ThomasVuNguyen/openflexure-v7/openscad/accessories/README.md

# Microscope accessories

This folder contains OpenSCAD files that build assemby tools and
various accessories for the microscope that aren't considered part of
the main build.  Currently this includes an adapter for a 1" disc
(allowing you to mount e.g. an optical fibre holder or resolution
target on the sample stage) and some options for mounting the
microscope onto a plate.

There are also foot prints of the microscope that are rendered into
SVGs to be use to (laser) cut case inserts or stands or the like.

These files aren't generally included in the build script, 
and tend not to be extensively tested - so treat them
with caution and do check they actually work before relying
on them.
