ThomasVuNguyen/openflexure-v7/docs/mount_optics_and_microscope.md

# Mount the optics and the microscope

{{include: mount_any_internals_and_microscope.md}}
