ThomasVuNguyen/openflexure-v7/docs/parts/electronics/camera_cable_200mm.md

----------------------
PartData:
  Name: Raspberry Pi Camera Ribbon Cable (200mm)
  Specs:
    Cable type: Type B FFC/FPC cable
    Length: 20cm
    Pitch: 1mm
    Pins: 15
  Suppliers:
    Farnell (Part number also for Newark and Onecall):
      Link: https://uk.farnell.com/multicomp-pro/mp-ffca10152003b/ffc-cord-15p-opposite-side-200mm/dp/3385343
      PartNo: 3385343
    The Pi Hut:
      Link: https://thepihut.com/products/flex-cable-for-raspberry-pi-camera-or-display-200mm-8
      PartNo: 102929
-----------------------
# 200mm ribbon cable for Raspberry Pi Camera Module V2.1. 

This is a 15 pin flat ribbon cable referred to as a FPC or FFC Type B cable with 1mm pitch.  
The 200mm length is longer than the standard ribbon cable the Pi Camera is sold with.

{{include: parts/electronics/camera_cable_warning.md}}
