ThomasVuNguyen/openflexure-v7/docs/parts/electronics/camera_cable_300mm.md

----------------------
PartData:
  Name: Raspberry Pi Camera Ribbon Cable (300mm)
  Specs:
    Cable type: Type B FFC/FPC cable
    Length: 30cm
    Pitch: 1mm
    Pins: 15
  Suppliers:
    Farnell (Part number also for Newark and Onecall):
      Link: https://uk.farnell.com/multicomp-pro/mp-ffca10153052b/ffc-cable-1-0mm-15way-305mm-white/dp/3527258
      PartNo: 3527258
    The Pi Hut:
      Link: https://thepihut.com/products/flex-cable-for-raspberry-pi-camera-or-display-300mm-12
      PartNo: 102795
-----------------------
# 300mm ribbon cable for Raspberry Pi Camera Module V2.1. 

This is a 15 pin flat ribbon cable referred to as a FPC or FFC Type B cable with 1mm pitch.  
The 300mm length is longer than the standard ribbon cable the Pi Camera is sold with.

{{include: parts/electronics/camera_cable_warning.md}}
