ThomasVuNguyen/openflexure-v7/docs/high_res_microscope.md

# High-resolution microscope

This is the standard research version of the OpenFlexure Microscope. It supports Standard RMS threaded objectives. It is a fully functioning motorised laboratory grade microscope. 

{{include: version_header_text.md}}

1. [.](test_your_printer.md){step}
1. [.](printing.md){step, var_type: high_res, var_mass_pla: 375}
1. [.](prepare_main_body.md){step}
1. [.](prepare_stand.md){step}
1. [.](actuator_assembly.md){step, var_n_actuators:3}
1. [.](high_res_optics_module.md){step}
1. [.](mount_optics_and_microscope.md){step, var_optics: rms}
1. [.](illumination.md){step, var_type: high_res}
1. [.](mount_illumination.md){step, var_type: high_res}
1. [.](motors.md){step, var_optics: rms}
1. [.](attach_clips.md){step, var_optics: rms}
1. [.](prepare_pi_and_sangaboard.md){step}
1. [.](wiring.md){step, var_optics: rms}
1. [.](finished.md){step, var_optics: rms}

A render of the completed high resolution microscope

There is also an [interactive 3D view](interactive_3d_view_rms.md) of the finished microscope.
