ThomasVuNguyen/openflexure-v7/docs/interactive_3d_view_upright.md

# Interactive 3D view of the OpenFlexure Microscope

Below is an interactive 3D view of the assembled microscope. This page shows an upright microscope with low cost optics using a Raspberry Pi camera module, and employing that camera module's lens as the microscope objective.

A render of the completed microscope
