ThomasVuNguyen/openflexure-v7/docs/motors.md

# Assemble the motors

{{BOM}}

[M3x10 cap head screws]: parts/mechanical.yml#CapScrew_M3x10mm_SS
[28BYJ-48 micro geared stepper motors]: parts/electronics.yml#28BYJ-48
[2.5mm Ball-end Allen key]: parts/tools/2.5mmBallEndAllenKey.md
[No 2 6.5mm self tapping screws]: parts/mechanical.yml#SelfTap_PoziPan_No2x6.5_SS
[#1 pozidrive screwdriver]: parts/tools/pozidrive_1_screwdriver.md "{cat:tool}"

## Attach the small gears {pagestep}





* Take a [stepper motor][28BYJ-48 micro geared stepper motors]{qty:3, cat:electronic} and a [small gear][small gears](fromstep){qty:3, cat:printedpart}.
* Place the motor on the work surface with the shaft pointing up.
* Align the flat sides of the motor shaft with the flat sides of the hole in the gear.
* Push the gear onto the motor with the flanged side downwards (motor side).
* Take two [self tapping screws][No 2 6.5mm self tapping screws]{qty: 6, cat:mech} and drive them fully into the holes on either side of the shaft, using a [#1 pozidrive screwdriver]{qty:1, cat:tool}
* Check that the gear is fully pushed on to the motor and the screws are fully in, so that the screw heads almost sit on the end of the motor shaft and the top of the heads are barely protruding from the gear. 
* Repeat for the other two motors

>i It is important to keep track of which motor cable corresponds to which axis. You may find it helpful to mark each cable connector with a marker or different-coloured tape before continuing.

## Check that the actuators are centred {pagestep}

Check actuator position
Check actuator position

* Look through the nut hole in the x actuator, above the 'X' logo
{{include: centre_actuators_text.md}}

## Attach the x and y motors {pagestep}




Note that each motor has a cable tidy cap that is different. Which cap to use should be apparent from the shape.

* Get a [2.5mm Ball-end Allen key]{qty:1, cat:tool} ready
* Feed the cable from the motor through the rectangular channel in the outer wall by the x actuator.
* Place the motor on the motor lugs with the small gear towards the outside of the microscope
* Check that the small gear and the large gear are meshed correctly
* Check that the motor screw points sit in the channel in the top of the motor lugs
* Take the x [cable tidy cap][cable tidy caps](fromstep){qty:3, cat:printedpart, note: "Each cap is a different shape"} and place it over the motor
* Check that the motor cable is running through the cable tidy rather than pinched underneath.
* Fasten the motor and cable tidy caps to the motor lugs with two [M3x10 cap head screws]{qty:6, cat:mech}
* Repeat for y-actuator

## Attach the z motor {pagestep}




{{includetext: " 
>i There is no motor attached to the z-actuator on the main body
", if: var_optics is upright}}  

* Feed the cable of the z motor down the rectangular slot to the left of the z actuator {{includetext: "on the main body", if: var_optics is upright}}
* Attach the motor to the z-actuator {{includetext: "of the separate z-actuator ", if: var_optics is upright}} in the same way as the x and y actuators
 {{includetext: "* Attach the z cable tidy cap to the motor lugs on the main body with two [M3x10 cap head screws]{qty:2, cat:mech}", if: var_optics is upright}}

## Secure the cable tidy caps {pagestep}




* Secure the x cable tidy cap with a [self tapping screw][No 2 6.5mm self tapping screws]{qty: 2, cat:mech} using a  [#1 pozidrive screwdriver]{qty:1, cat:tool}
* Repeat for the y cable tidy cap
