ThomasVuNguyen/openflexure-v7/docs/mount_any_internals_and_microscope.md

{{BOM}}

[2.5mm Ball-end Allen key]: parts/tools/2.5mmBallEndAllenKey.md

## Mount the {{includetext:"optics", if: var_optics is not upright}}{{includetext:"illumination module", if: var_optics is upright}} {pagestep}






* Get the [2.5mm Ball-end Allen key]{qty:1, cat:tool} ready{{includetext:"
* Hold the [complete optics module](fromstep){qty:1, cat:subassembly}  with the cable arranged to one side of the camera platform", if: var_optics is c270}}
* {{includetext:"Take the [complete optics module](fromstep){qty:1, cat:subassembly} and pass", if: var_optics is not upright and var_optics is not c270}}{{includetext:"Take the [assembled illumination module](fromstep){qty:1, cat:subassembly} and pass", if: var_optics is upright}} {{includetext:"Pass", if: var_optics is c270}} it {{includetext:"through the bottom", if: var_optics is not c270}}{{includetext:"between the front legs", if: var_optics is c270}} of the [microscope][microscope with assembled actuators](fromstep){qty:1, cat:subassembly}.
* Insert exposed the mounting screw on the optics module through the keyhole on the z-actuator.






* Insert the Allen key through the teardrop shaped hole on the front of the microscope. Until it engages with the mounting screw.
* Slide the {{includetext:"optics module", if: var_optics is not upright}}{{includetext:"illumination module", if: var_optics is upright}} up the keyhole as high as it will go.
* Tighten the screw with the Allen key to lock the optics in place.

{{include: mount_microscope.md}}
