ThomasVuNguyen/openflexure-v7/docs/mount_illumination.md

# Mount the illumination

{{BOM}}

[M3 nut]: parts/mechanical.yml#Nut_M3_SS "{cat:mech}"
[M3 stainless steel washers]: parts/mechanical.yml#Washer_M3_SS "{cat:mech}"
[M3x10 cap head screws]: parts/mechanical.yml#CapScrew_M3x10mm_SS "{cat:mech}"
[2.5mm Ball-end Allen key]: parts/tools/2.5mmBallEndAllenKey.md "{cat:tool}"

## Mount the dovetail {pagestep}




* Place the [illumination dovetail][Illumination dovetail](fromstep){qty:1, cat:printedpart} onto the stage above the z-actuator of the main body.
* Secure in place with two [M3x10 cap head screws]{qty:2} and 2 [M3 Washers][M3 stainless steel washers]{qty: 2} (using [2.5mm Ball-end Allen key]{qty:1})

## Insert the illumination wiring {pagestep}





* Take the [assembled illumination module](fromstep){qty: 1, cat:subassembly}
* Pass the illumination cable from the top to the bottom of the cable guide in the illumination dovetail.
* Pass the illumination cable from the top to the bottom of the cable guide in the main body, between the Z gear and the Y gear.

## Mount the condenser arm {pagestep}





* Slide the condenser arm into the illumination dovetail until the bottom of the illumination module is about 5mm from the top of the microscope stage
* Tighten the thumbscrew by hand to lock the arm in place
* You will need to fine tune the position to focus the illumination on the sample when you first use the microscope
