ThomasVuNguyen/openflexure-v7/docs/prepare_main_body_motor_nuts.md

[M3 nut]: parts/mechanical.yml#Nut_M3_SS

## Embed mounting nuts for the X and Y motors {pagestep}





* Repeat the steps used above to add two [M3 nuts][M3 nut]{qty:4, cat:mech} each to the X and Y motor mounts (Only Y axis side shown in the images)

{{include:prepare_main_body_z_nuts.md}}
