ThomasVuNguyen/openflexure-v7/docs/prepare_main_body_z_nuts.md

[M3 nut]: parts/mechanical.yml#Nut_M3_SS

## Embed mounting nuts for the Z motor {pagestep}





* Repeat the steps used above to add two [M3 nuts][M3 nut]{qty:2, cat:mech} to the Z motor mount
