ThomasVuNguyen/openflexure-v7/docs/usb_cameras/c270_preparation.md

# Prepare the Logitech C270 HD webcam for mounting 

This section describes how to disassemble a Logitech C270 HD webcam and prepare it to use with C270 versions of Openflexure optics modules. The Logitech C270 HD webcam is not supported in the Openflexure software, but it can be used with many simple webcam programs.

{{BOM}}

[flat blade screwdriver]: ../parts/tools/flat_blade_screwdriver.md "{cat:tool}"
[#0 Phillips screwdriver]: ../parts/tools/phillips_0_screwdriver.md "{cat:tool}"
[side cutters]: ../parts/tools/precision-wire-cutters.md "{cat:tool}"
[pliers]: ../parts/tools/pliers.md "{cat:tool}"

[Logitech C270 HD webcam]: ../parts/electronics.yml#Logitech_C270 "{cat:electronic}"

>! **Warning**
>! 
>! You will need to break the case of the camera, and you will need to take care not to damage the camera board and sensor.   
>! Do this at your own risk

{{include: manual_optics_note.md, if: var_body is _manual}}

## Open the C270 case {pagestep}






* Take the [Logitech C270 webcam][Logitech C270 HD webcam]{qty: 1} and place it on a clean surface
* Release the outer bezel with a [flat blade screwdriver]{qty:1}
* Remove the bezel and discard it
* Unscrew three screws holding the inner front cover, using a [#0 Phillips screwdriver]{qty:1}
* Save the screws 
* Remove the inner cover and discard it

## Remove the camera board from the case {pagestep}






>! **Caution!**
>!
>! The camera board is static sensitive.

* Before touching the camera board touch a metal earthed object. If you own one, consider wearing and anti-static strap
* Remove the small rubber tube from the microphone and discard it. The microphone is the cylindrical component in the middle of the board, it is the largest component other than the camera.
* Unscrew two screws holding the camera board, using a [#0 Phillips screwdriver]{qty:1}
* Save the screws. You will need four of the five that you have saved for mounting the camera if you are using a lens spacer. You will need one if you are using a high resolution optics module. Keep the rest as spares
* Release the board from the case. It is still attached to the case by the cable
* Remove the E-clip from the cable retainer with a [flat blade screwdriver]{qty:1}
* Release the cable retainer from the case
* Cut the case to make a slot from the cable hole to the edge, using [side cutters]{qty: 1}. Take care not to cut the cable
* Remove the board cable from the case and discard the case.

## Remove the microphone {pagestep}





* Grasp the microphone with small [pliers]{qty: 1}
* Carefully twist forwards and backwards to break the small wires connecting the microphone to the board (you could alternatively unsolder the wires from the back of the board). Discard the microphone
* Remove the white plastic spacer and discard it
* If the microphone wires remain attached to the PCB,  grasp them with small [pliers]{qty: 1}. Twist them to break and discard them

## Remove the lens {pagestep}




>! **Caution!**
>!
>! The camera sensor is very delicate  
>! Work in a dust-free area

* Place the camera board with the lens facing down
* Unscrew two screws holding the lens mount to the camera board, using a [#0 Phillips screwdriver]{qty:1} 
* Save both screws for mounting the camera if you are using an Openflexure RMS optics module. These screws are different from the others as they have a small flange
* Turn the camera board over 
* Hold the lens assembly and carefully pull it from the board. The lens assembly is held with double-sided tape and requires a little force to remove.
* Retain the lens assembly if you are going to use the basic optics module with a lens spacer
* Remove the small foam pad from the board, next to the lens mount

>! **Caution!**
>!
>! Attach the camera sensor to your optics module as soon as possible so that it does not collect dust 

## Prepare the lens to use in the basic optics module  {pagestep}



* Grasp the square lens mount and the knurled round lens holder
* Unscrew the lens from the mount. There is some force required to start to unscrew the lens as it is held in place with a little glue
* Sometimes the glue is too stiff to unscrew using fingers. Carefully use a pair of small [pliers]{qty: 1} to hold the knurled round lens holder

The [prepared Logitech C270 camera]{output, qty:1} and lens are now ready to attach to your {{includetext:"optics module or", if: , if: var_body is not _manual}} lens spacer

[No 1 self tapping screws]{output, qty:5, hidden}
[No 1 self tapping flanged screws]{output, qty:2, hidden}
[C270 camera board]{output, qty:1, hidden}
