ThomasVuNguyen/openflexure-v7/docs/low_cost_microscope.md

# Low-cost microscope

This is a lower cost version of the OpenFlexure Microscope. It uses the lens from the Raspberry Pi Camera to produce a microscope with field of view about 750×560μm, similar to using a 20x objective. It is motorised, but you can also build it as a manual microscope.

{{include: version_header_text.md}}

1. [.](test_your_printer.md){step}
1. [.](printing.md){step, var_type: low_cost, var_mass_pla: 375}
1. [.](prepare_main_body.md){step}
1. [.](prepare_stand.md){step}
1. [.](actuator_assembly.md){step, var_n_actuators:3}
1. [.](basic_optics_module.md){step, var_lens: pi_lens}
1. [.](mount_optics_and_microscope.md){step, var_optics: low_cost}
1. [.](illumination.md){step, var_type: low_cost}
1. [.](mount_illumination.md){step, var_optics: low_cost}
1. [.](motors.md){step, var_optics: low_cost}
1. [.](attach_clips.md){step, var_optics: low_cost}
1. [.](prepare_pi_and_sangaboard.md){step}
1. [.](wiring.md){step, var_optics: low_cost}
1. [.](finished.md){step, var_optics: low_cost}

A render of the completed microscope using the Raspberry Pi camera module's lens.

There is also an [interactive 3D view](interactive_3d_view_low_cost.md) of the finished microscope.
