ThomasVuNguyen/openflexure-v7/docs/parts/materials/black_pla_filament.md

# Black PLA filament

Certain parts specifically require black filament ([more information](../../info_pages/why_optics_black.md)).

Use the same [type of filament](pla_filament.md) as for other parts.
