ThomasVuNguyen/openflexure-v7/rendering/librender/logos/MicroSD-Logo.dxf

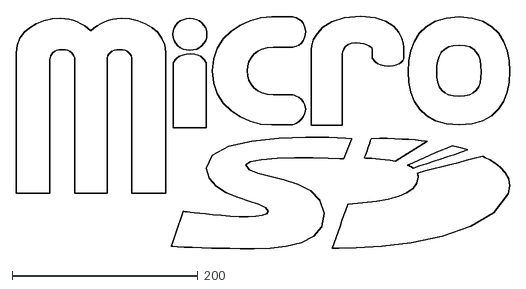
[picture p1: CAD file, 2026-09-27]
rendering/librender/logos/MicroSD-Logo.dxf
531.0 x 250.0
