ThomasVuNguyen/openflexure-v7/openscad/lens_spacer.scad

/**
* This is an alternative optics module that is to
* be used together with the camera platform, to make a cheap
* optics module that uses the webcam lens.  New in this version
* is compatibility with the taller stage (because the sensor is
* no longer required to sit below the microscope body).
*/


use <./libs/microscope_parameters.scad>
use <./libs/lib_optics.scad>
use <./libs/optics_configurations.scad>

lens_spacer_stl();

module lens_spacer_stl(){
    params = default_params();
    optics_config = pilens_config();
    lens_spacer(params, optics_config);
}
