ThomasVuNguyen/openflexure-v7/openscad/accessories/picamera_2_lens_removal_tool.scad

// this file just pulls out one module from picamera_2

use <../libs/cameras/picamera_2.scad>

picamera_2_lens_removal_tool();
