ThomasVuNguyen/openflexure-v7/(list of files, cad)

Other CAD files:
rendering/electronics/led_board_colors/led_board_CAD1EE.stl
rendering/electronics/sangaboard_colors/sangaboard_151618.stl
rendering/electronics/led_board_colors/led_board_DBBC7E.stl
rendering/electronics/sangaboard_colors/sangaboard_200235D4.stl
rendering/electronics/led_board_colors/led_board_FFFFFF.stl
rendering/electronics/sangaboard_colors/sangaboard_B66D2E.stl
rendering/electronics/led_board_colors/led_board_262525.stl
rendering/electronics/sangaboard_colors/sangaboard_E4E3CF.stl
rendering/electronics/led_board_colors/led_board_F5F5F5.stl
rendering/electronics/sangaboard_colors/sangaboard_5F5F5F.stl
rendering/electronics/led_board_colors/led_board_808080.stl
rendering/electronics/sangaboard_colors/sangaboard_F5F5F5.stl
rendering/electronics/led_board_colors/led_board_BF9C3B.stl
rendering/electronics/sangaboard_colors/sangaboard_614537.stl
rendering/electronics/led_board_colors/led_board_200235D4.stl
rendering/electronics/sangaboard_colors/sangaboard_292929.stl
rendering/electronics/led_board_colors/led_board_000000.stl
rendering/electronics/sangaboard_colors/sangaboard_D2D1C7.stl
rendering/electronics/sangaboard_colors/sangaboard_262525.stl
rendering/electronics/sangaboard_colors/sangaboard_808080.stl
rendering/electronics/sangaboard_colors/sangaboard_DBBC7E.stl
rendering/electronics/sangaboard_colors/sangaboard_464646.stl
rendering/electronics/sangaboard_colors/sangaboard_BF9C3B.stl
rendering/electronics/sangaboard_colors/sangaboard_B0A998.stl
rendering/electronics/sangaboard_colors/sangaboard_000000.stl
openscad/lens_spacer_b0196.scad
openscad/lens_spacer_c270.scad
openscad/main_body_manual.scad
rendering/librender/rendered_main_body_manual.scad
openscad/accessories/1_inch_disc_holder.scad
openscad/accessories/actuator_drilling_jig.scad
openscad/accessories/actuator_tension_band.scad
openscad/accessories/picamera_2_gripper.scad
openscad/accessories/slide_box.scad
openscad/accessories/upright_z_actuator_mount_10mm_sample.scad
openscad/accessories/upright_z_actuator_mount_5mm_sample.scad
openscad/actuator_assembly_tools.scad
openscad/c270_backshell.scad
openscad/camera_platform.scad
openscad/camera_platform_b0196.scad
openscad/camera_platform_c270.scad
openscad/condenser.scad
openscad/condenser_aperture.scad
openscad/condenser_board_spacer.scad
openscad/condenser_diffuser.scad
openscad/condenser_led_holder.scad
openscad/condenser_lid.scad
openscad/electronics_drawer.scad
openscad/feet.scad
openscad/fl_cube.scad
openscad/foot_cap.scad
openscad/gear_tools.scad
openscad/gear_tools_ratios.scad
openscad/illumination_dovetail.scad
openscad/illumination_thumbscrew.scad
openscad/large_gears.scad
openscad/led_array_holder.scad
openscad/lens_tool.scad
openscad/microscope_stand.scad
openscad/microscope_stand_no_pi.scad
openscad/nano_converter_plate.scad
openscad/nano_converter_plate_gripper.scad
openscad/picamera_2_cover.scad
openscad/reflection_illuminator.scad
openscad/rms_optics_module.scad
openscad/sample_clips.scad
openscad/separate_z_actuator.scad
openscad/separate_z_actuator_manual.scad
openscad/simple_post_stand.scad
openscad/slide_riser.scad
openscad/small_gears.scad
openscad/test_pieces/leg_test.scad
openscad/test_pieces/nut_trap_test.scad
openscad/test_pieces/rms_thread.scad
openscad/test_pieces/trylinder_selftap_holes_test.scad
openscad/thumbwheels.scad
openscad/upright_condenser.scad
openscad/upright_condenser_platform.scad
openscad/upright_feet.scad
openscad/upright_large_gears.scad
openscad/upright_z_actuator_mount.scad
rendering/band_tool_assembly.scad
rendering/brim_and_ties_separate_z_actuator.scad
rendering/complete_microscope.scad
rendering/complete_microscope_low_cost.scad
rendering/complete_microscope_manual.scad
rendering/complete_microscope_rms.scad
rendering/complete_microscope_upright.scad
rendering/condenser_assembly.scad
rendering/librender/optics.scad
rendering/librender/render_settings.scad
rendering/librender/rendered_components.scad
rendering/librender/rendered_separate_z_actuator.scad
rendering/librender/rendered_separate_z_actuator_manual.scad
rendering/librender/tools.scad
rendering/microscope_stand.scad
rendering/mount_electronics.scad
rendering/mount_microscope.scad
rendering/mount_sample_clips.scad
rendering/mount_upright_optics.scad
rendering/optics_assembly.scad
rendering/prepare_nut_trap_test.scad
rendering/prepare_pi_and_sangaboard.scad
rendering/prepare_picamera.scad
rendering/prepare_stand.scad
rendering/rms_optics_assembly.scad
rendering/upright_condenser_assembly.scad
rendering/workaround_5mm_led.scad
