ThomasVuNguyen/openflexure-v7/docs/c270_only_printing.md

{{include: inverted_only_printing.md}}
* [Lens spacer]{output,qty:1}: [lens_spacer_c270.stl](models/lens_spacer_c270.stl){previewpage} - **This must be printed in [black][Black PLA filament]{Qty: 20g}!** [i](info_pages/why_optics_black.md)
* [Camera backshell]{output, qty:1}: [c270_camera_backshell.stl](models/c270_camera_backshell.stl){previewpage}
* [Camera platform]{output,qty:1}: [camera_platform_c270.stl](models/camera_platform_c270.stl){previewpage}

You can [download all of the STLs as a single zipfile]{{includetext: "(low-cost-stls.zip)", if: var_body is not _manual}}{{includetext: "(manual-stls.zip)", if: var_body is _manual}}{zip, pattern:"*.stl"}

[Black PLA filament]: parts/materials/black_pla_filament.md "{cat:material}"
