ThomasVuNguyen/openflexure-v7/docs/manual_microscope.md

# Manual microscope

>! This version of the OpenFlexure Microscope does not include motors. There is no autofocus or slide scanning.

This version is the simplest version of the microscope. It is suitable for manual operation using a web-cam like the Logitech C270, to produce a microscope with field of view about 750μm, similar to using a 20x objective. [Other optics modules](customisations/optics_options.md) can also be used with this microscope, using the Logitech C270 or other cameras.

{{include: version_header_text.md}}

1. [.](test_your_printer.md){step}
1. [.](printing.md){step, var_type: c270, var_body: _manual, var_mass_pla: 275}
1. [.](prepare_main_body.md){step, var_body: _manual}
1. [.](prepare_stand.md){step, var_body: _manual}
1. [.](actuator_assembly.md){step, var_body: _manual, var_actuators: _manual, var_n_actuators:3}
1. [.](usb_cameras/c270_preparation.md){step, var_body: _manual}
1. [.](basic_optics_module.md){step, var_body: _manual, var_lens: c270_lens}
1. [.](mount_optics_and_microscope.md){step, var_optics: c270, var_body: _manual}
1. [.](illumination.md){step, var_optics: c270, var_body: _manual}
1. [.](mount_illumination.md){step, var_optics: c270, var_body: _manual}
1. [.](attach_clips.md){step, var_optics: c270, var_body: _manual}
1. [.](wiring_manual.md){step, var_optics: c270, var_body: _manual}
1. [.](finished.md){step, var_optics: c270, var_body: _manual}

A render of the completed manual microscope, using a Logitech C270 camera.

There is also an [interactive 3D view](interactive_3d_view_c270_manual.md) of the finished microscope.
