ThomasVuNguyen/openflexure-v7/docs/manual_optics_note.md

>i These instructions guide you through assembling the manual microscope with most compact and low cost optics system, using a Logitech C270 webcam in a basic optics module.  
>i
>i STLs for using an Arducam B0196 webcam or a Raspberry Pi camera v2 in a similar module can be found in the list of basic optics modules on the [optics customisations](customisations/optics_options.md) page.
