ThomasVuNguyen/openflexure-v7/docs/printing_manual_only.md

* [Manual main body]{output,qty:1}: [main_body_manual.stl](models/main_body_manual.stl){previewpage} - The smart brim may require [custom print settings].
* [Microscope stand]{output, qty:1}: [microscope_stand_no_pi.stl](models/microscope_stand_no_pi.stl){previewpage} - As an even more compact but less stable option you could use the [simple_post_stand.stl](models/simple_post_stand.stl){previewpage} instead
* 3 [thumbwheels]{output,qty:3}: [thumbwheels.stl](models/thumbwheels.stl){previewpage}
