ThomasVuNguyen/openflexure-v7/docs/printing_motorised_only.md

* [Main body]{output,qty:1}: [main_body.stl](models/main_body.stl){previewpage} - The smart brim may require [custom print settings].
* 3 [cable tidy caps]{output,qty:3}: [{{includetext:"upright_", if: var_type is upright}}cable_tidies.stl](models/{{includetext:"upright_", if: var_type is upright}}cable_tidies.stl){previewpage}
* [Microscope stand]{output, qty:1}: [microscope_stand.stl](models/microscope_stand.stl){previewpage}
* [Electronics drawer]{output, qty:1}: [electronics_drawer-pi4_sanga_stack_11mm.stl](models/electronics_drawer-pi4_sanga_stack_11mm.stl){previewpage} - **This electronics drawer is for a Pi 4 and HAT-style Sangaboard with 11mm tall headers. For all other combinations of electronics, refer to the [customisation page](customisation.md)**
* 3 [small gears]{output,qty:3}: [small_gears.stl](models/small_gears.stl){previewpage}
