ThomasVuNguyen/openflexure-v7/docs/wiring.md

# Complete the wiring

[customisation]: customisation.md "Customisation and work-around options for the microscope."
[motor electronics workaround]: workaround_motor_electronics/workaround_motor_electronics.md "Solutions to drive the motors without a Sangaboard PCB."

{{BOM}}

>! **Note on Sangaboard v0.5**
>!
>! The Sangaboard v0.5 from our preferred supplier has 11mm tall header connectors. If you purchase a board from another supplier and they use standard 8.5mm headers you will need to print a [different electronics drawer](customisations/drawer_options.md)

>i **Alternative electronics options**
>i 
>i
>i If you are using a version of the Raspberry Pi other than v4, or Sangaboard other than v0.5, you [may need a different electronics drawer](customisations/drawer_options.md).
>i
>i If you do not have a Sangaboard, you can make up a compatible solution from a microcontroller and separate driver boards.  This is described in the [motor electronics workaround] page.

[No 2 6.5mm self tapping screws]: parts/mechanical.yml#SelfTap_PoziPan_No2x6.5_SS "{cat:mech}"
[M3 nut]: parts/mechanical.yml#Nut_M3_SS "{cat:mech}"
[M3x10 cap head screws]: parts/mechanical.yml#CapScrew_M3x10mm_SS "{cat:mech}"
[#1 pozidrive screwdriver]: parts/tools/pozidrive_1_screwdriver.md "{cat:tool}"
[2.5mm Ball-end Allen key]: parts/tools/2.5mmBallEndAllenKey.md "{cat:tool}"

## Assembly video



## Prepare nuts for the electronics drawer {pagestep}






* Place an [M3 nut]{qty:1, cat:mech} into the slot just inside the hole in the front of the microscope stand.
* Place another [M3 nut]{qty:1} into the slot near the Sangaboard power connector on the [electronics drawer][Electronics drawer](fromstep){qty:1, cat:printedpart} you printed earlier .

## Fit the Raspberry Pi {pagestep}

>i Your Raspberry Pi requires the OpenFlexure Server software in order to work. This is installed as an operating system image on an SD card, which must be inserted into the Pi before it is fitted in the microscope stand. Refer to [this step](prepare_pi_and_sangaboard.md#load-the-openflexure-operating-system-onto-the-sd-card).





* Take the [electronics drawer] and push the [Raspberry Pi (with SD card and software installed)][Pi with software](fromstep){qty:1, cat:electronic} into place so the connectors show through the holes. The connectors are recessed into both walls of the drawer, so a small rotation and a little force is required for this step. 
* Secure the Raspberry Pi in place with two [No 2 self tapping screws][No 2 6.5mm self tapping screws]{qty:2}, using a [screwdriver][#1 pozidrive screwdriver]{qty: 1}.

## Attach the camera ribbon cable {pagestep}



* Identify the 'camera' port of the Raspberry Pi, between the micro-HDMI connector and the Headphone jack.
* Insert the ribbon cable from the optics module into the camera port of the Rasberry Pi. Ensure that the contacts are on the opposite side from the clasp.
*{info} There are [detailed instructions on the Rasbperry Pi website](https://projects.raspberrypi.org/en/projects/getting-started-with-picamera/2). 

## Fit the Sangaboard {pagestep}

>i Your Sangaboard requires firmware in order to work. If you have purchased the board pre-flashed with firmware, it will already be installed. If you have made the board yourself, refer to [this step](prepare_pi_and_sangaboard.md#prepare-the-sangaboard).




* Mount the [Sangaboard (with firmware installed)][Sangaboard with firmware](fromstep){qty:1, cat:electronic} onto the Raspberry Pi GPIO pins, ensuring that the ribbon cable from the optics module passes through the slot.
* Check that the connector is aligned so that it covers all of the pins on the 40-pin connector on the Raspberry Pi, and that the Sangaboard mounting holes line up with the mounting points.
* Secure the Sangaboard in place with two [No 2 self tapping screws][No 2 6.5mm self tapping screws]{qty:2}, using a [screwdriver][#1 pozidrive screwdriver]{qty: 1}.

## Connect the motors to the Sangaboard {pagestep}





* Push the x motor cable into its labelled connector.
* Push the y and z motor cables into their labelled connectors. Make sure the motor from the correct axis on the microscope goes to the correct port.

## Connect the LED to the Sangaboard {pagestep}

>i If you have used the [5mm LED workaround](workaround_5mm_led/workaround_5mm_led.md), or you have an older illumination PCB with a constant current driver installed you will need to follow the [alternative connection instructions](workaround_5mm_led/power_workaround_led.md).

Connect the LED to the Sangaboard

* Locate the LED cable from the microscope.
* Plug the 2-pin female connector onto the 2 way male header labelled "**CC**" on the Sangaboard v0.5.

>i "CC" stands for Constant Current, it is the best way to reliably drive the LED.

## Mount the electronics drawer {pagestep}






* Slide the [electronics drawer] into the microscope base, making sure not to pinch any wires.
* Hold the [electronics drawer] in place with two [M3x10 cap head screws]{qty: 2} using a [2.5mm Allen key][2.5mm Ball-end Allen key]{qty: 1}. The screws should screw into the two nuts inserted in Step 1.

## Wiring Complete {pagestep}

To power up your microscope you will need a [power supply][Raspberry Pi Power Supply](parts/electronics.yml#RaspberryPi_PowerSupply){qty:1, cat:electronic}. The microscope is powered through the Sangaboard v0.5 USB-C socket.
